rtek1000/RF_Magic_Controller_6803_IC/Non_STM8_Board/Readme.md

Unfortunately they are already using an alternative IC to the STM8, in this case it is an HC89S003A.

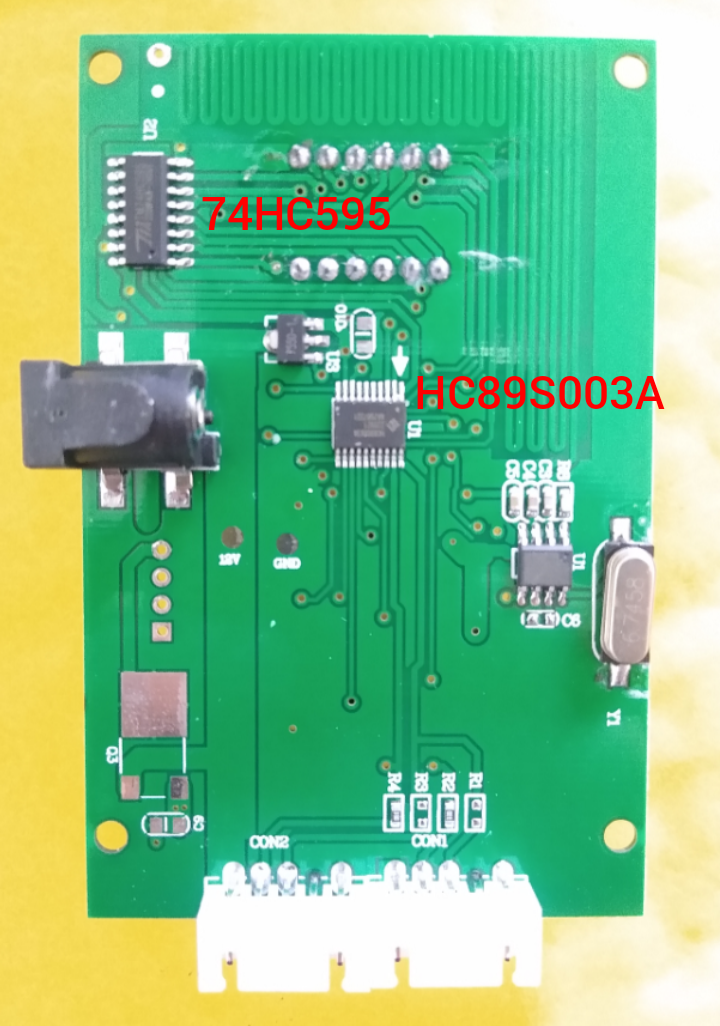
[picture p5: Non_STM8_Board/Board-HC89S003A.png]
