rtek1000/RF_Magic_Controller_6803_IC/Arduino_Modified_Hardware/MCP4725/README.md

# Modified hardware:
- The RF signal input from the remote control is originally connected to the PB4 pin, but on this pin there is the I2C hardware module.
To expand the capacity of available pins, without needing much hardware change, I chose to use a PCF8574 port expander.
For this I modified (cut) the track of the RF receiver of the remote control and connected it to the PD4 pin of the uC STM8.
I will also need an MCP4725 to generate an analog output with 12-bit precision, another option would be to create a DAC using PWM, but it can cause ripple noise.

- To run sample code from this folder you must use modified hardware.

- Note:  ̶U̶n̶f̶o̶r̶t̶u̶n̶a̶t̶e̶l̶y̶ ̶I̶ ̶s̶t̶i̶l̶l̶ ̶c̶o̶u̶l̶d̶n̶'̶t̶ ̶g̶e̶t̶ ̶t̶h̶e̶ ̶I̶2̶C̶ ̶p̶o̶r̶t̶ ̶t̶o̶ ̶w̶o̶r̶k̶ ̶c̶o̶r̶r̶e̶c̶t̶l̶y̶  (Update: dac_test.ino sketch works finally) there are some posts that say they had problems with I2C on these STM8S, and in my case the I2C_GetFlagStatus() function seems to be unable to read the register and so the routine freezes. The problem seems to be the lack of interrupt, because the initialization of the I2C module does not trigger interrupt events, so asking the code to wait for an interrupt, the code is stuck forever. Basically I found two initializations, one that activates the interrupt and one that does not activate. The arduino core for STM8S I'm using should be the one that doesn't activate the interrupt:
- - https://github.com/timypik/STM8S-Library/blob/master/libstm8s/inc/stm8s_i2c.h
- This other file shows the activation of the interrupt on line 88:
- - https://github.com/HomeSmartMesh/STM8_IoT_HelloWorld/blob/master/18_STM8L_HelloI2C/i2c.c
- Info: https://github.com/tenbaht/sduino/issues/143

- I2C port ref.:
- - https://www.youtube.com/watch?v=gR7oqUz4CW4
- - https://github.com/timypik/STM8S-Library/blob/master/libstm8s/src/stm8s_i2c.c
- STM8 optimized I2C examples (AN3281) <---- see this one (code sample)
- - https://www.st.com/resource/en/application_note/an3281-stm8-8bit-mcus-ic-optimized-examples-stmicroelectronics.pdf

Reference:



# Note:
- The Test_remote_control_HM folder contains the code separated into parts, to try to improve the readability
