rtek1000/RF_Magic_Controller_6803_IC/Non_STM8_Board/Board-HC89S003A_1.png

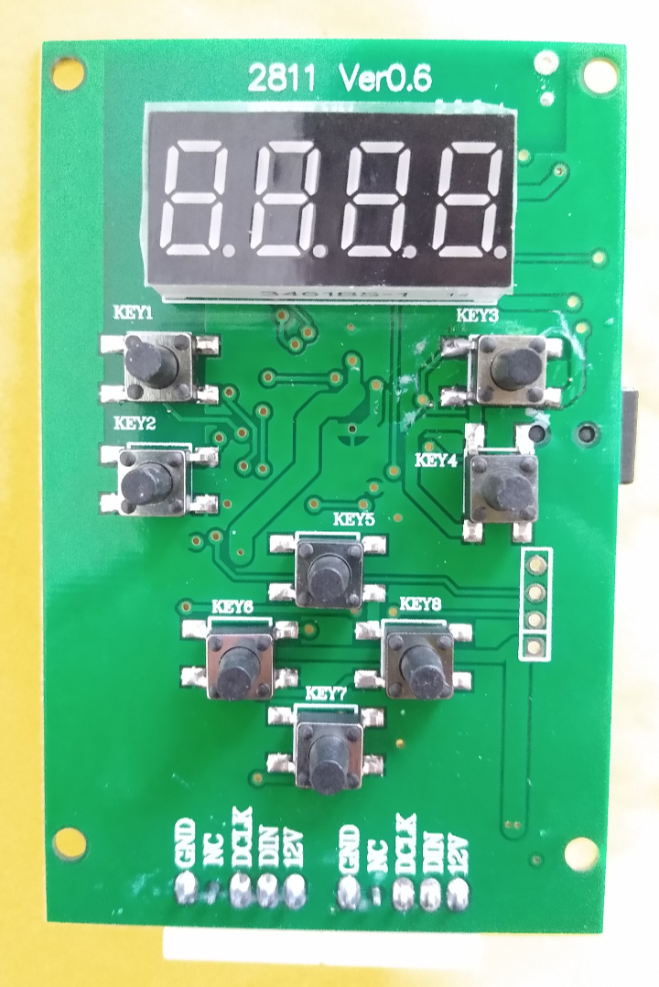
Non_STM8_Board/Board-HC89S003A_1.png
