rtek1000/RF_Magic_Controller_6803_IC/Arduino_Modified_Hardware/RF_Magic_Controller_6803_IC.pdf

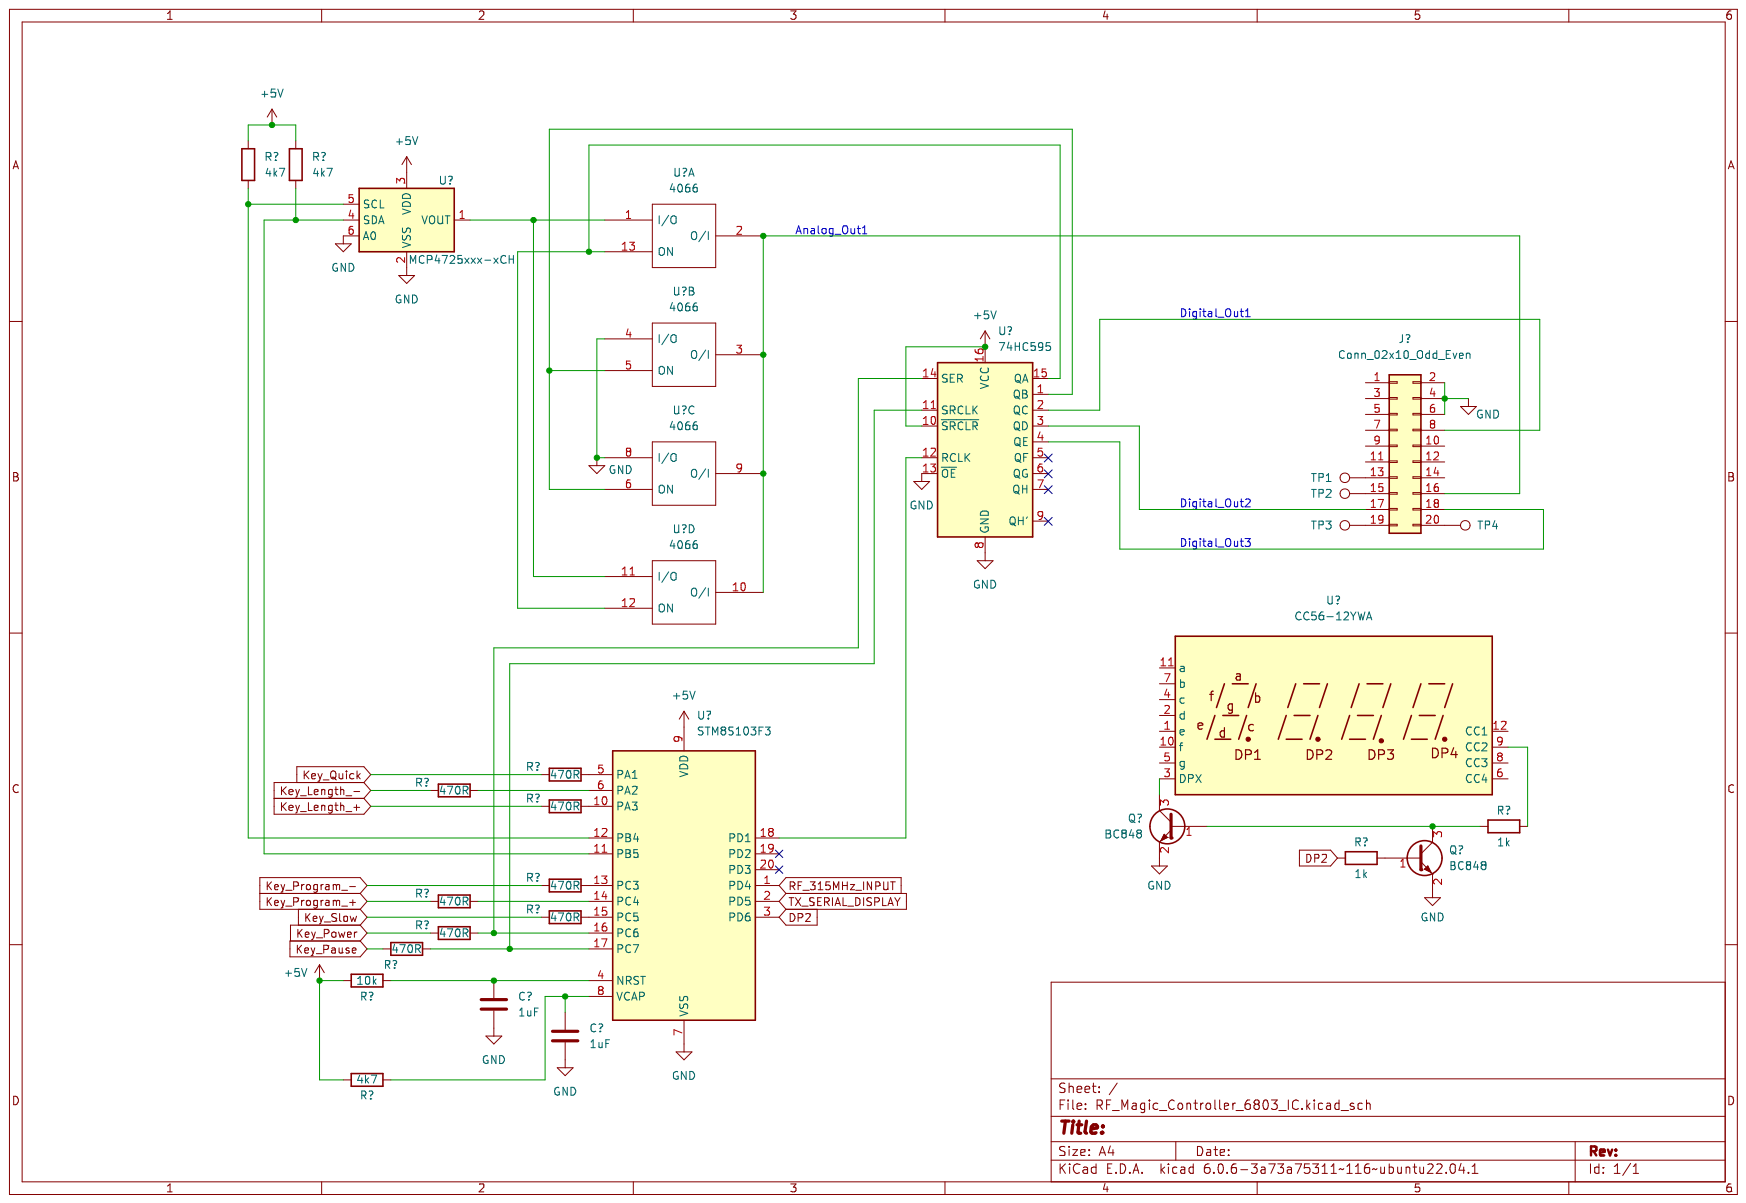
[picture p7: page 1]
