rtek1000/RF_Magic_Controller_6803_IC/Arduino_Modified_Hardware/MCP4725/RF_Magic_Controller_6803_IC_MCP4725.pdf

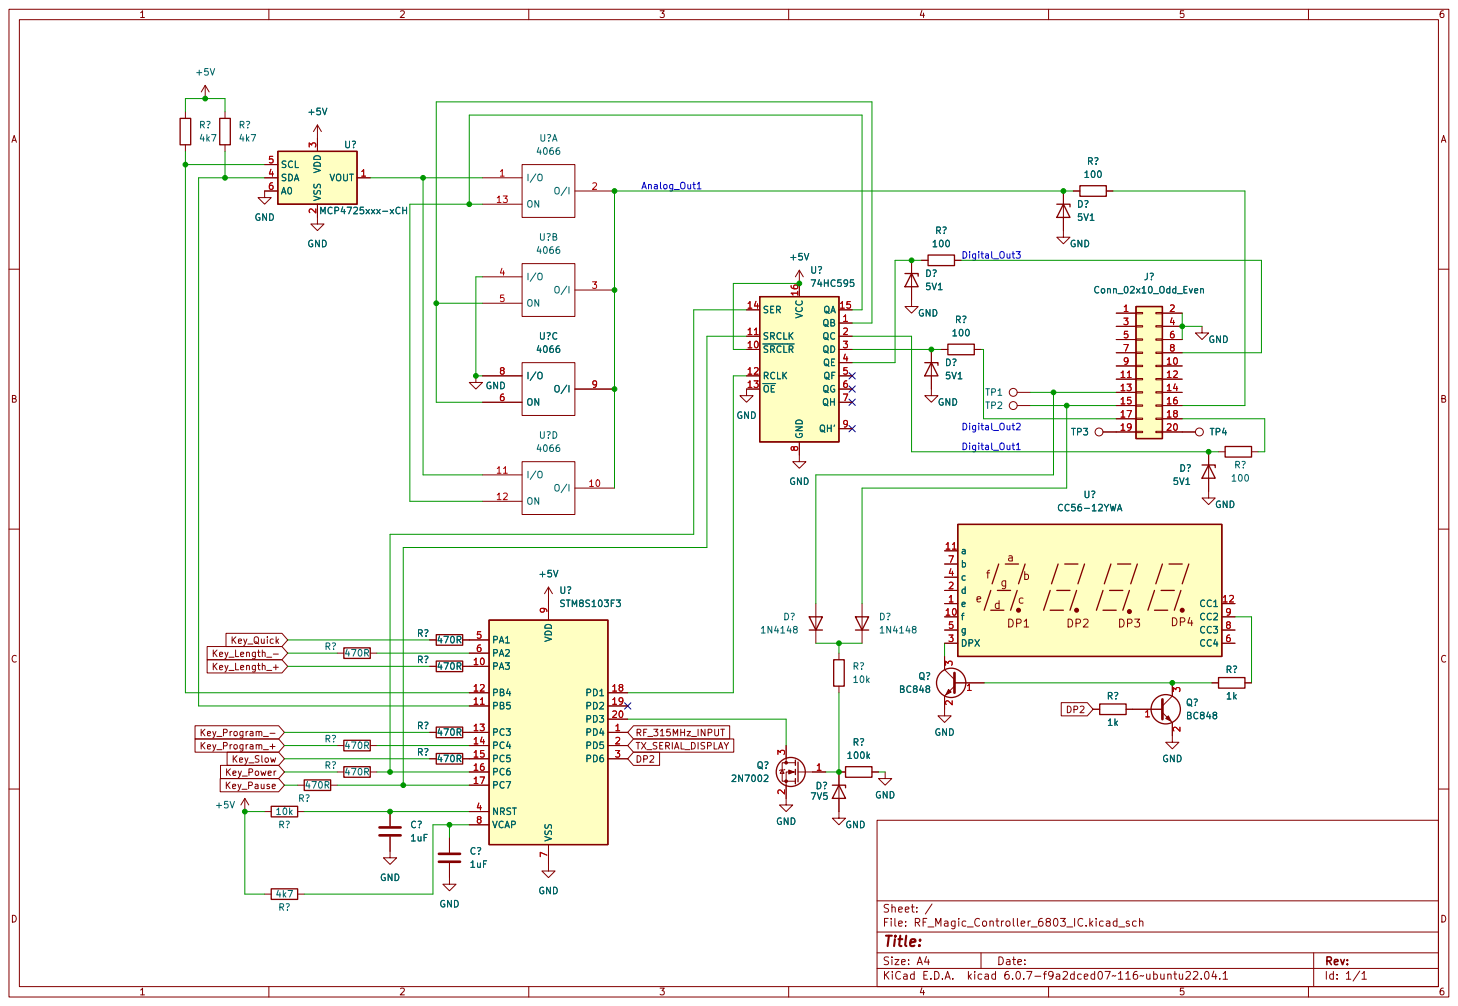
[picture p8: page 1]
